CldyBnyhni/Multicolor-MOD/README.md

# Multicolor-MOD
# 本仓库仅为个人修改的MOD文件不是完整文件。
# 以上MOD文件仅为测试使用用途，不得进行商用售卖。
