CldyBnyhni/Multicolor-MOD/cfg/README.md

# 添加MOD文件，使用快乐兔V2来运行切刀
在mmu_parameters.cfg 文件里设置 gcode_unload_sequence: 1 



在mmu_software.cfg 文件里设置gcode_macro _MMU_UNLOAD_SEQUENCE 添加MOD切刀宏 _CUT
