CldyBnyhni/Multicolor-MOD/TradRack编码器/TCRT5000编码器/线轨座.stl

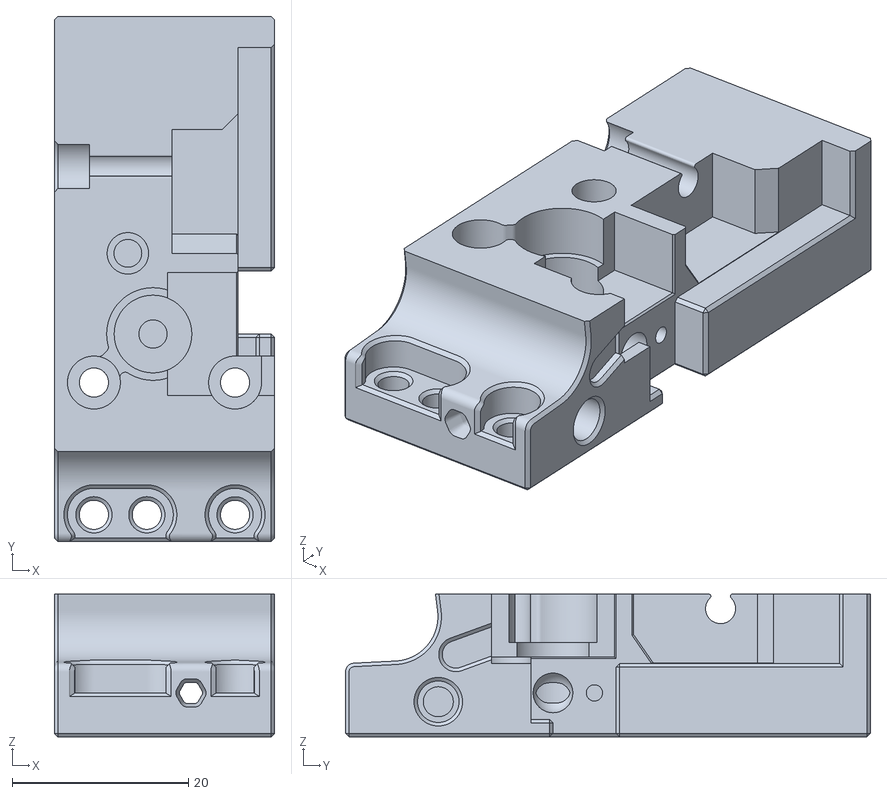
[picture p1: CAD file, 2023-12-05]
TradRack编码器/TCRT5000编码器/线轨座.stl
25.0 x 59.5 x 16.2
