CldyBnyhni/Multicolor-MOD/TradRack编码器/光栅编码器/线轨座.stl

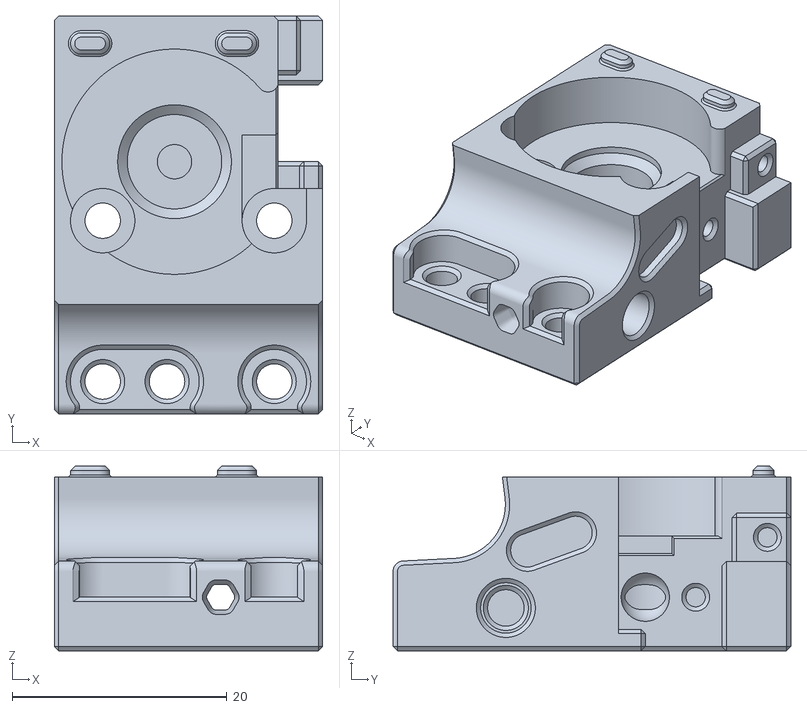
[picture p2: CAD file, 2023-11-30]
TradRack编码器/光栅编码器/线轨座.stl
25.0 x 37.1 x 17.2
