CldyBnyhni/Multicolor-MOD/TradRack编码器/改PCB5000编码器/线轨座盖.stl

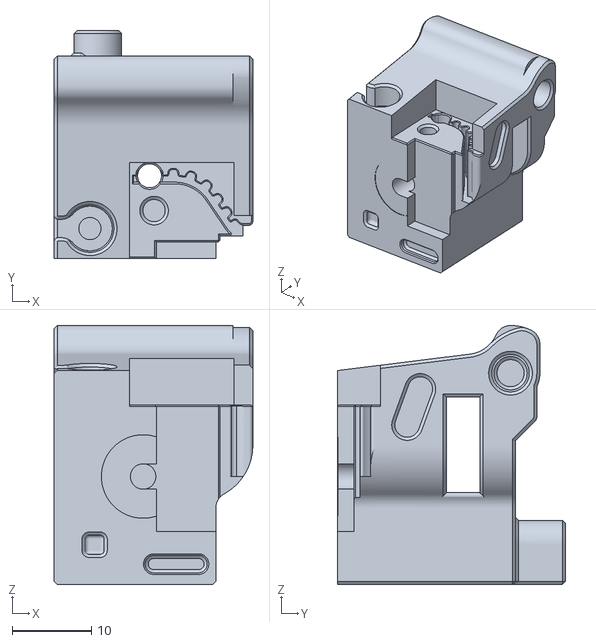
[picture p3: CAD file, 2023-12-03]
TradRack编码器/改PCB5000编码器/线轨座盖.stl
25.0 x 28.7 x 32.6
