CldyBnyhni/Multicolor-MOD/其他STL/垃圾桶.stl

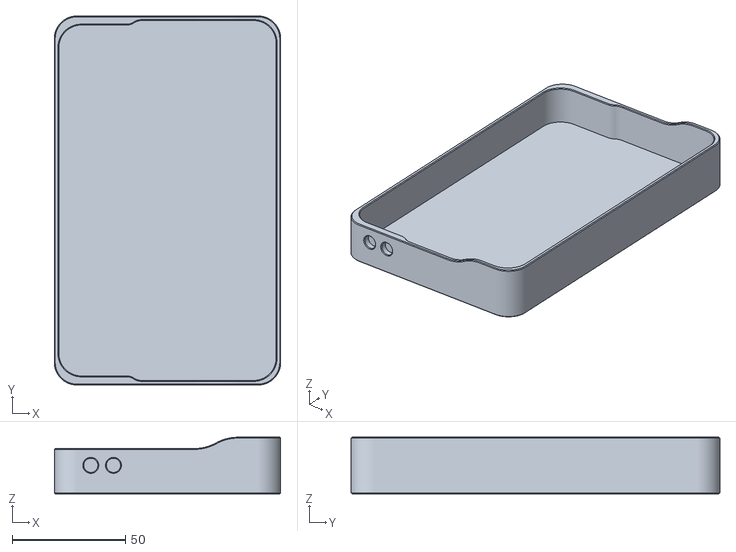
[picture p4: CAD file, 2023-12-10]
其他STL/垃圾桶.stl
100.0 x 163.0 x 25.0
