CldyBnyhni/Multicolor-MOD/切刀2/刀座长刀片.stl

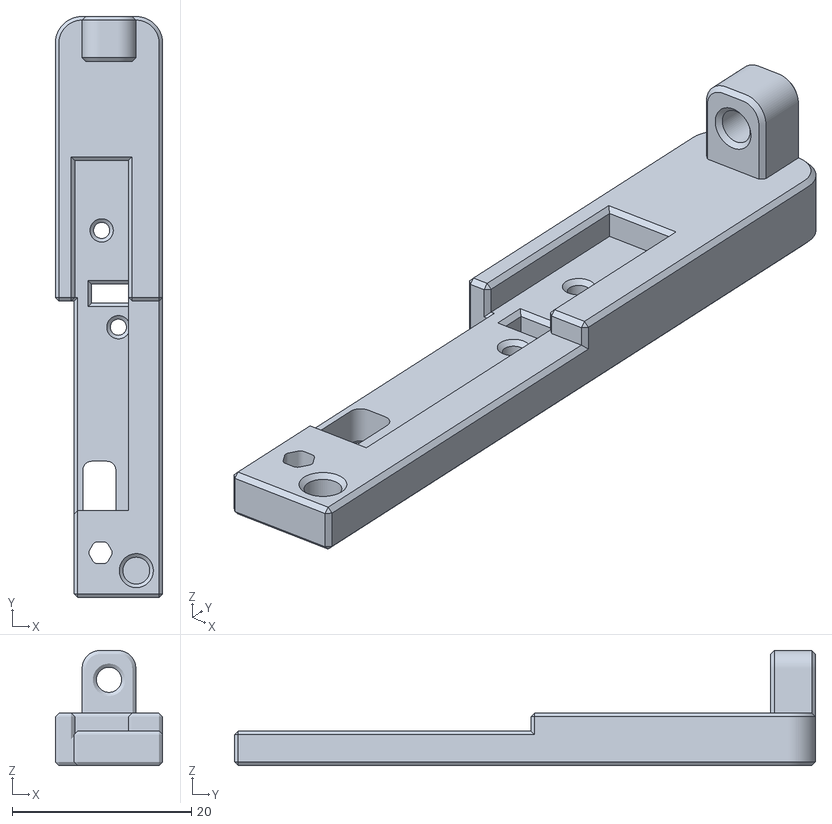
[picture p5: CAD file, 2023-12-10]
切刀2/刀座长刀片.stl
12.0 x 64.9 x 12.9
