CldyBnyhni/Multicolor-MOD/TradRack编码器/改PCB5000编码器/线轨座M2热熔.stl

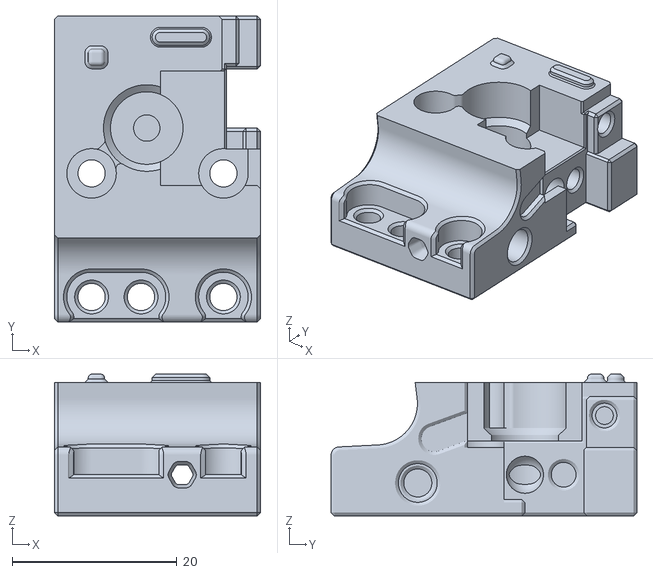
[picture p7: CAD file, 2023-12-03]
TradRack编码器/改PCB5000编码器/线轨座M2热熔.stl
25.0 x 37.1 x 17.2
