CldyBnyhni/Multicolor-MOD/TradRack编码器/TCRT5000编码器/编码器偏孔.stl

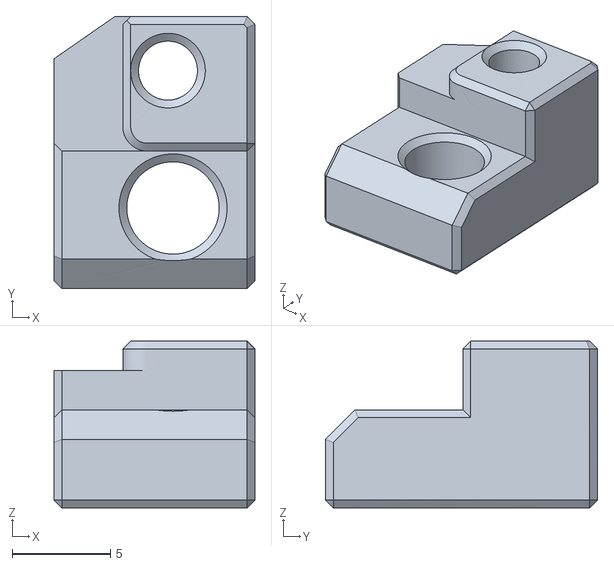
[picture p8: CAD file, 2023-12-05]
TradRack编码器/TCRT5000编码器/编码器偏孔.stl
10.2 x 13.9 x 8.50
