CldyBnyhni/Multicolor-MOD/其他STL/Junction_Plate_Flat_2.stl

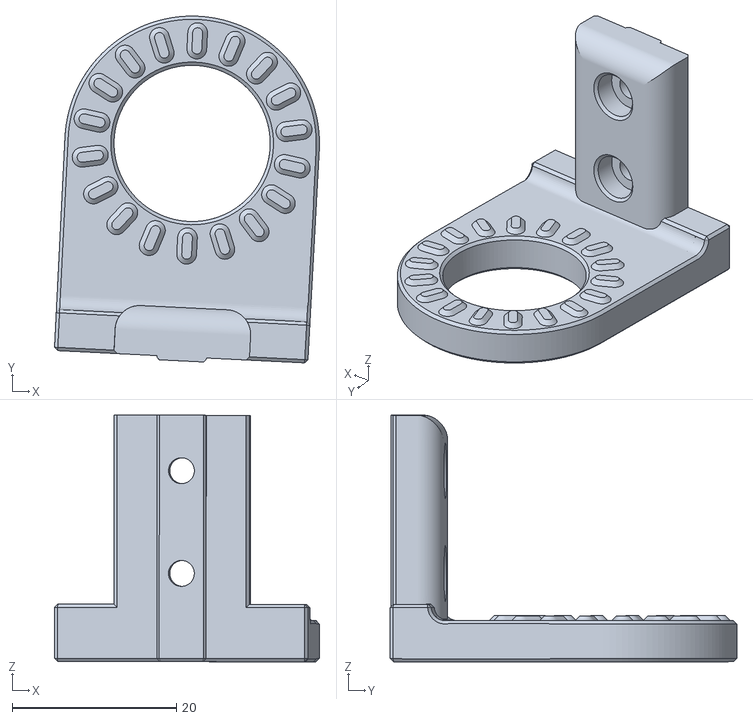
[picture p9: CAD file, 2023-12-03]
其他STL/Junction_Plate_Flat_2.stl
32.3 x 42.2 x 30.0
