CldyBnyhni/Multicolor-MOD/切刀2/弹簧座.stl

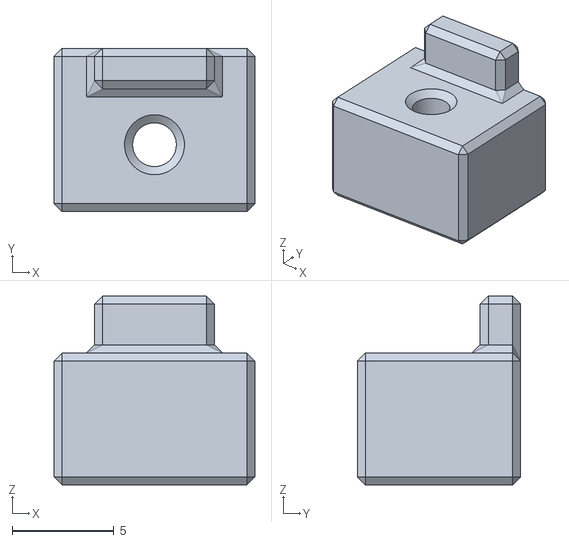
[picture p10: CAD file, 2023-12-03]
切刀2/弹簧座.stl
9.90 x 8.05 x 9.30
