CldyBnyhni/Multicolor-MOD/TradRack编码器/TCRT5000编码器/线轨座盖.stl

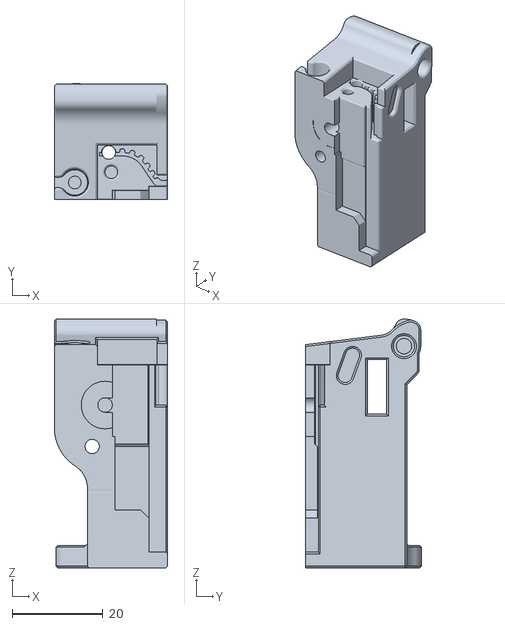
[picture p11: CAD file, 2023-12-05]
TradRack编码器/TCRT5000编码器/线轨座盖.stl
25.0 x 25.7 x 55.0
