CldyBnyhni/Multicolor-MOD/TradRack编码器/光栅编码器/码盘.stl

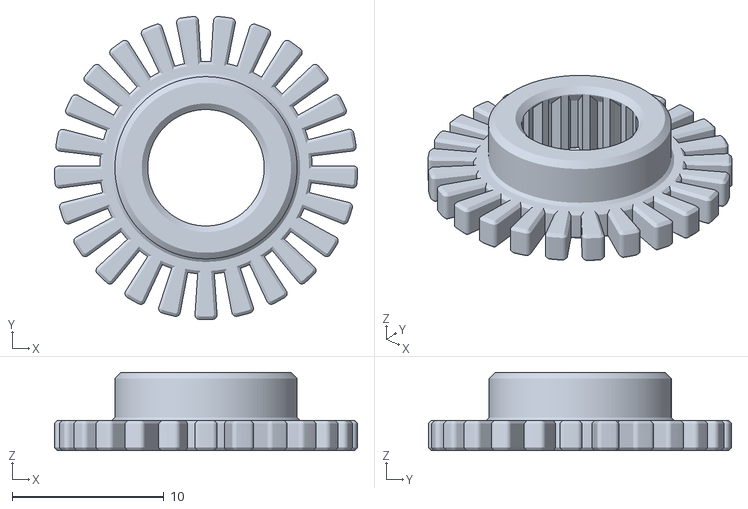
[picture p12: CAD file, 2023-11-30]
TradRack编码器/光栅编码器/码盘.stl
20.0 x 20.0 x 5.17
