CldyBnyhni/Multicolor-MOD/TradRack编码器/改PCB5000编码器/小黑盒.stl

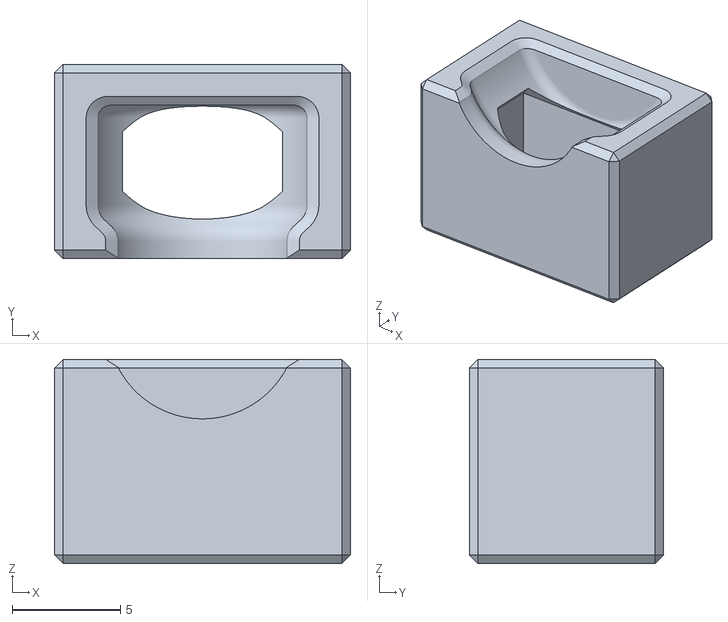
[picture p13: CAD file, 2023-12-03]
TradRack编码器/改PCB5000编码器/小黑盒.stl
13.7 x 9.00 x 9.45
