CldyBnyhni/Multicolor-MOD/切刀2/切料座.stl

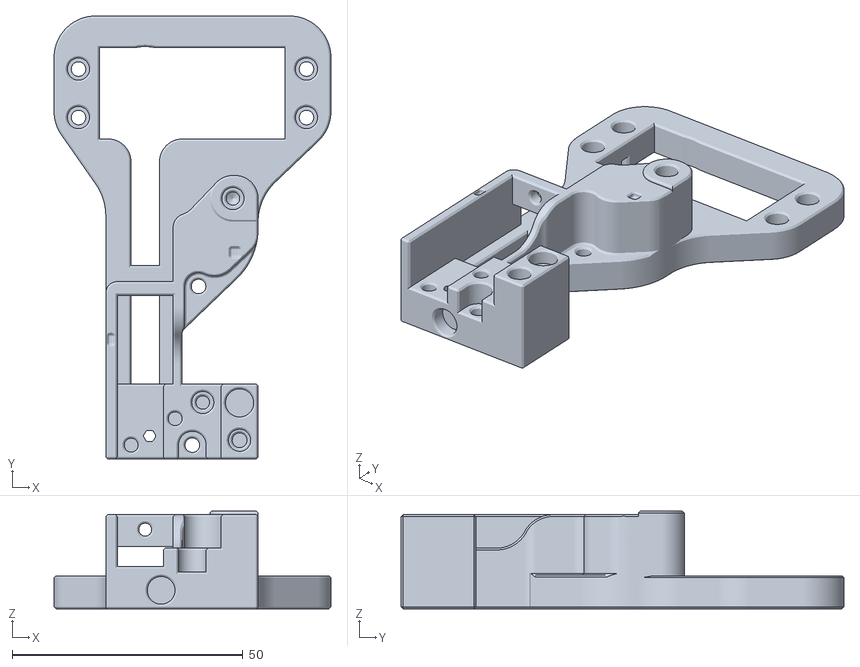
[picture p14: CAD file, 2023-12-03]
切刀2/切料座.stl
60.0 x 96.0 x 21.1
