CldyBnyhni/Multicolor-MOD/TradRack编码器/TCRT5000编码器/⭐钢珠弹簧盖.stl

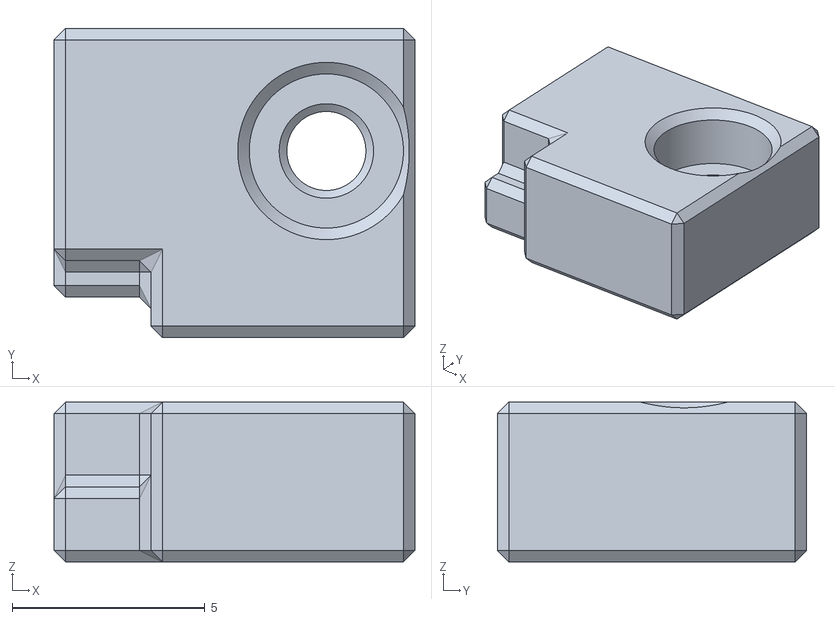
[picture p15: CAD file, 2023-12-03]
TradRack编码器/TCRT5000编码器/⭐钢珠弹簧盖.stl
9.37 x 8.03 x 4.15
