CldyBnyhni/Multicolor-MOD/切刀2/鲍登阀门.stl

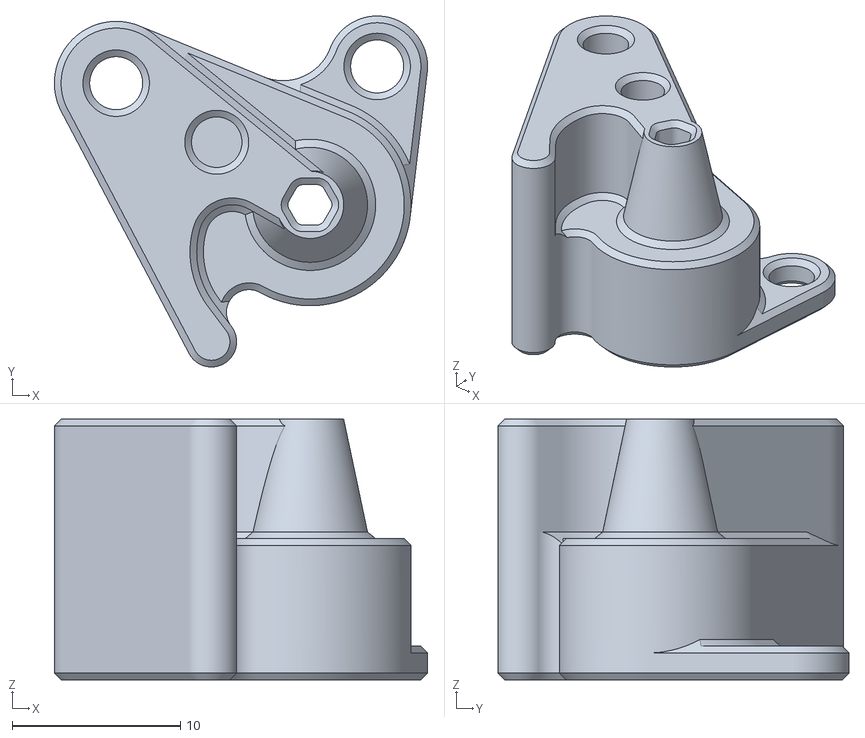
[picture p16: CAD file, 2023-12-03]
切刀2/鲍登阀门.stl
22.2 x 20.9 x 15.5
