CldyBnyhni/Multicolor-MOD/TradRack编码器/TCRT5000编码器/鲍登盖.stl

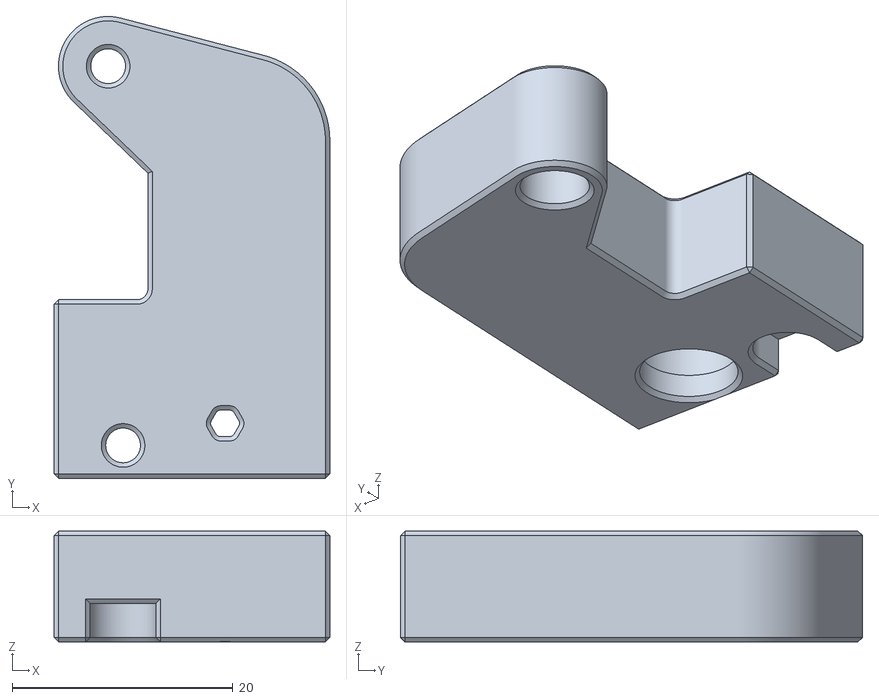
[picture p17: CAD file, 2023-12-03]
TradRack编码器/TCRT5000编码器/鲍登盖.stl
25.0 x 41.9 x 10.0
