CldyBnyhni/Multicolor-MOD/切刀2/切料盖.stl

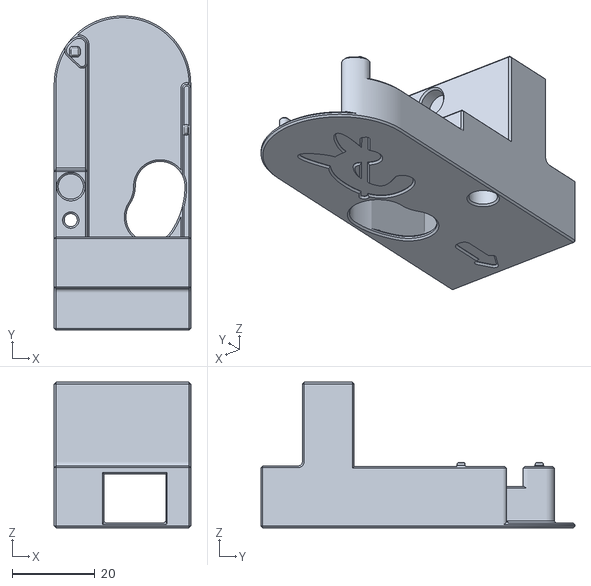
[picture p18: CAD file, 2023-12-03]
切刀2/切料盖.stl
33.0 x 75.9 x 35.2
