CldyBnyhni/Multicolor-MOD/TradRack编码器/TCRT5000编码器/⭐皮带盖.stl

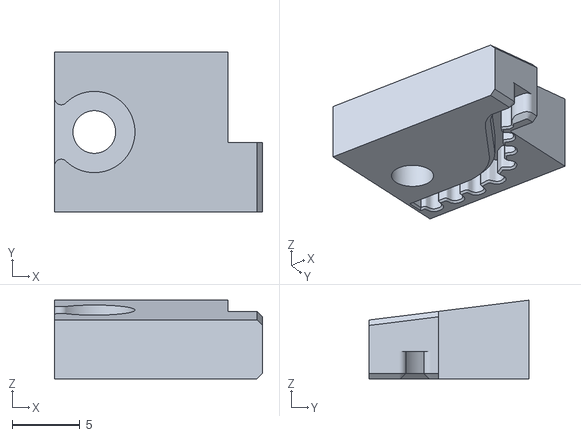
[picture p19: CAD file, 2023-12-03]
TradRack编码器/TCRT5000编码器/⭐皮带盖.stl
15.4 x 11.8 x 5.81
