CldyBnyhni/Multicolor-MOD/切刀2/运动杆.stl

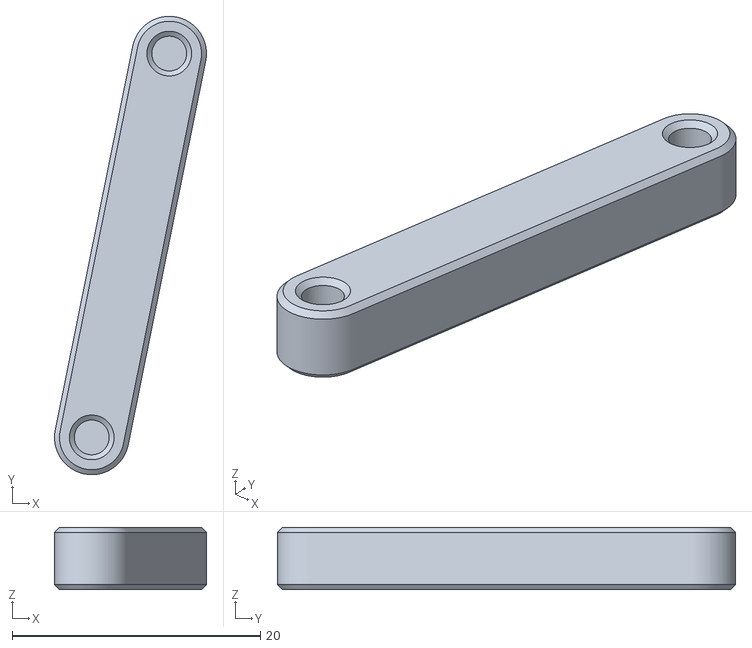
[picture p20: CAD file, 2023-12-03]
切刀2/运动杆.stl
12.2 x 36.9 x 5.00
