CldyBnyhni/Multicolor-MOD/切刀2/舵机臂.stl

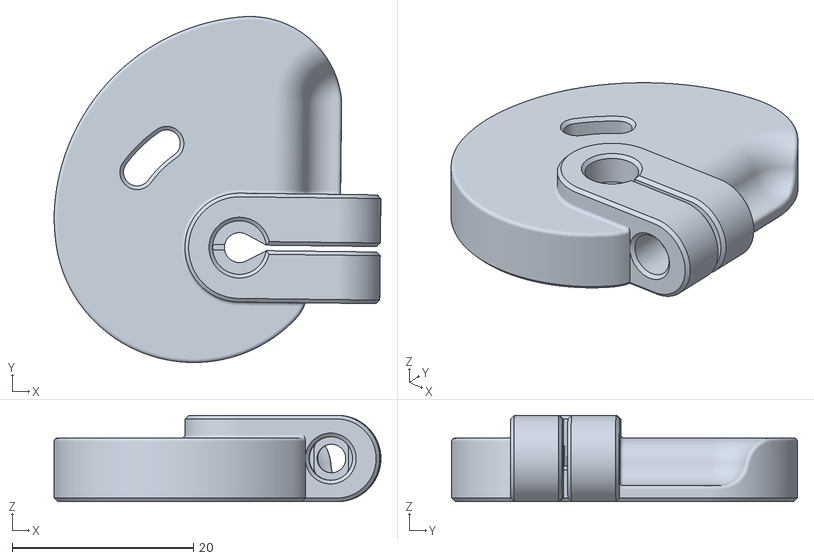
[picture p21: CAD file, 2023-12-03]
切刀2/舵机臂.stl
36.0 x 38.2 x 9.50
