CldyBnyhni/Multicolor-MOD/切刀2/运动臂.stl

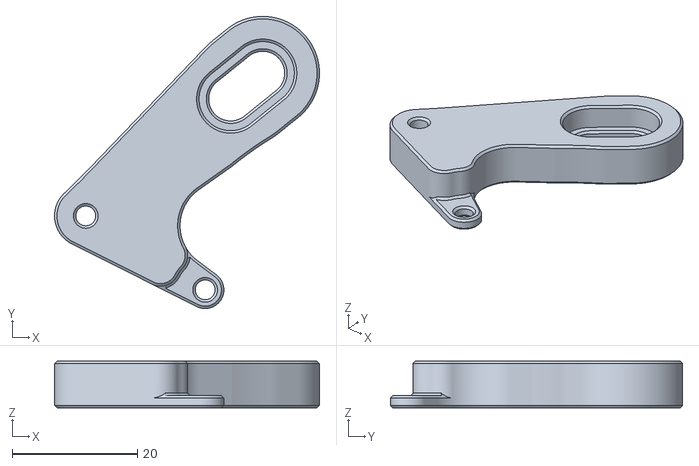
[picture p22: CAD file, 2023-12-03]
切刀2/运动臂.stl
42.4 x 46.7 x 7.50
