CldyBnyhni/Multicolor-MOD/(list of files, cad)

Other CAD files:
TradRack编码器/光栅编码器/线轨座2MM土八螺母.stl
切刀2/刀座.stl
TradRack编码器/光栅编码器/线轨座盖.stl
TradRack编码器/改PCB5000编码器/线轨座.stl
其他STL/[a]_Screw_x3.stl
