CldyBnyhni/Multicolor-MOD/(commit log)

2023-11-30 Create TradRack光电开关编码器
2023-11-30 Create README.md
    TradRack编码器
